dilshan/speaker-selector/ecad/speaker_selector.pdf

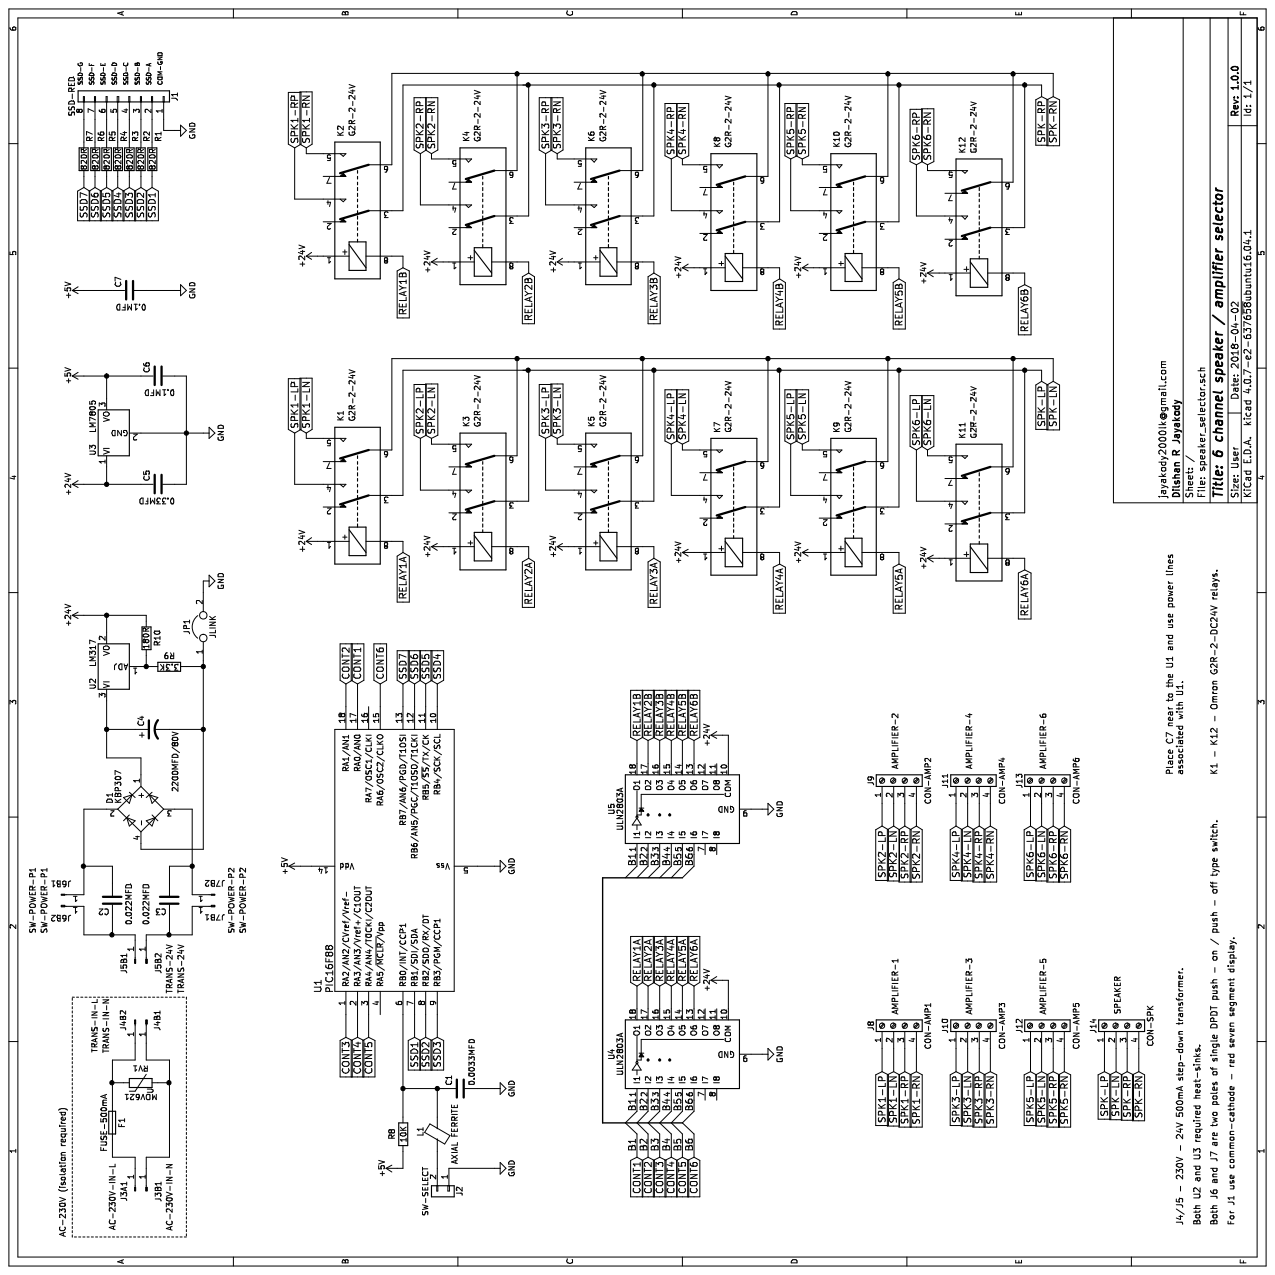
[picture p1: page 1]
