dilshan/speaker-selector/ecad/speaker_selector.sch

## KiCad design ecad/speaker_selector.sch (2018-04-17)

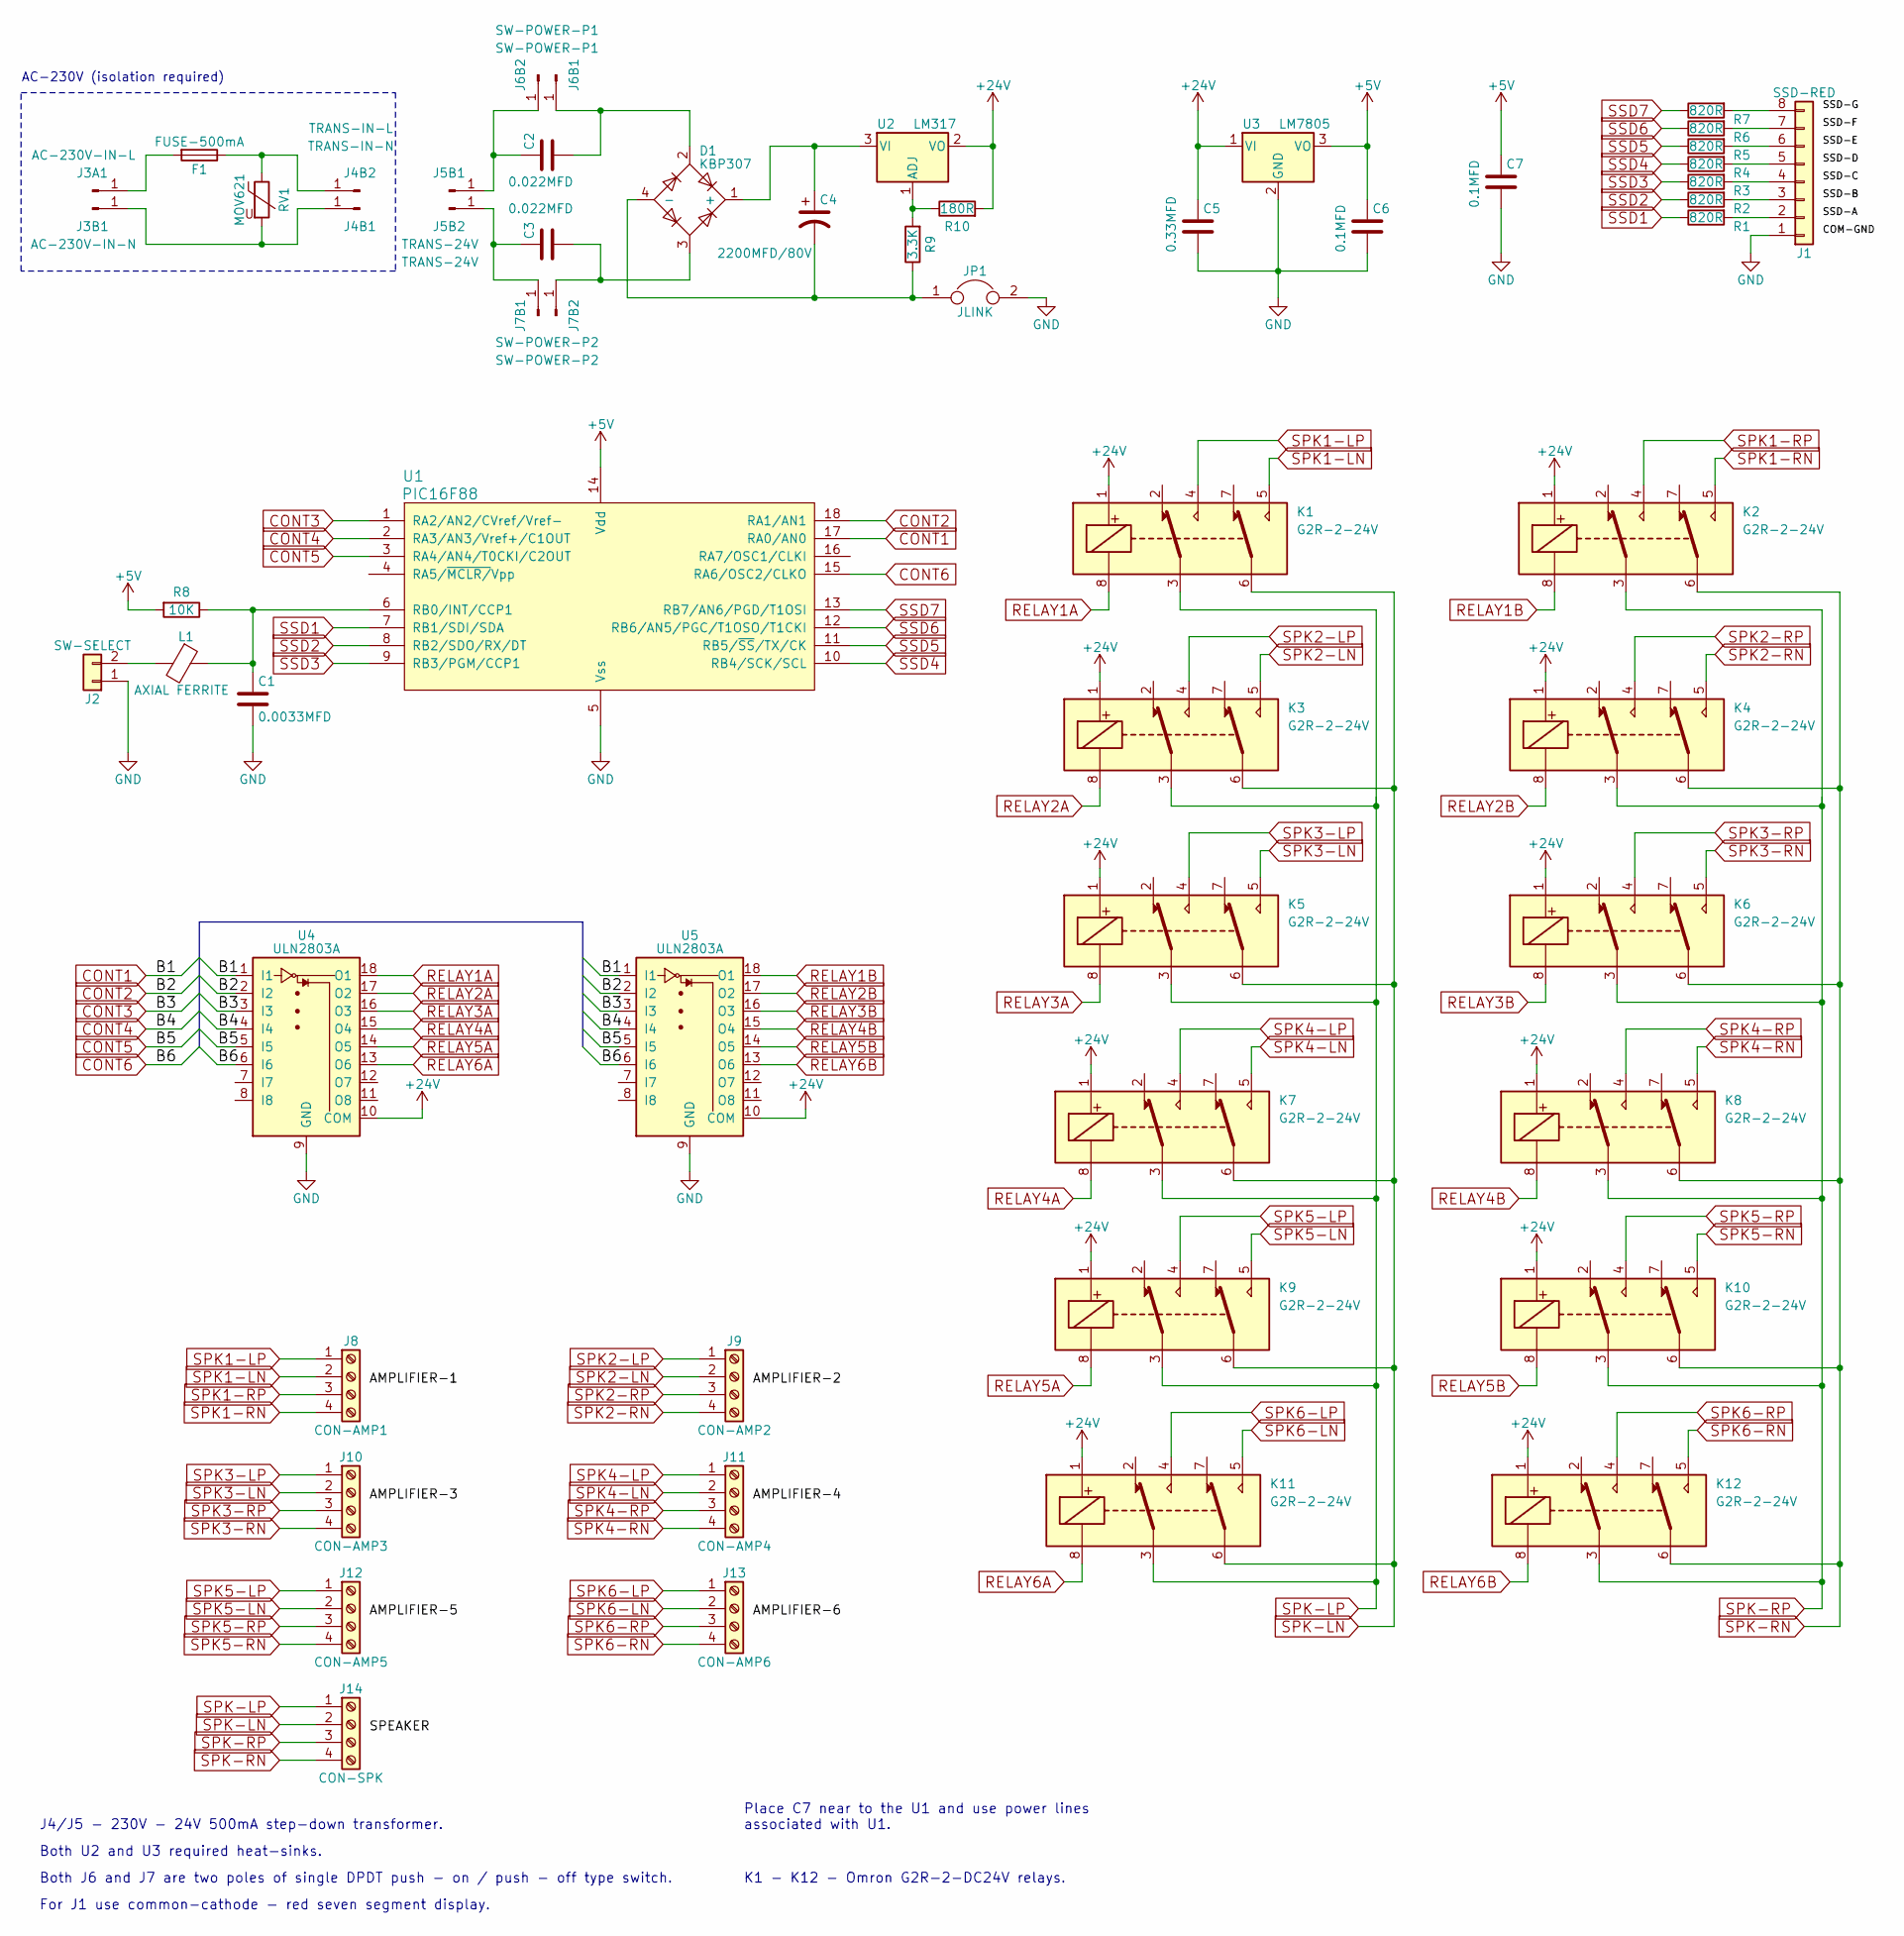
[picture p2: schematic speaker_selector.sch]

Parts:
C1: 0.0033MFD; C_Disc_D4.7mm_W2.5mm_P5.00mm
C2, C3: 0.022MFD; C_Rect_L19.0mm_W9.0mm_P15.00mm_MKS4
C4: 2200MFD/80V; CP_Radial_D16.0mm_P7.50mm
C5: 0.33MFD; C_Rect_L7.0mm_W6.0mm_P5.00mm
C6, C7: 0.1MFD; C_Rect_L7.0mm_W4.5mm_P5.00mm
D1: KBP307
F1: FUSE-500mA; Fuseholder5x20_horiz_open_inline_Type-I
J1: SSD-RED
J2: SW-SELECT
J3A1: AC-230V-IN-L
J3B1: AC-230V-IN-N
J4B1: TRANS-IN-L
J4B2: TRANS-IN-N
J5B1, J5B2: TRANS-24V
J6B1, J6B2: SW-POWER-P1
J7B1, J7B2: SW-POWER-P2
J8: CON-AMP1
J9: CON-AMP2
J10: CON-AMP3
J11: CON-AMP4
J12: CON-AMP5
J13: CON-AMP6
J14: CON-SPK
JP1: JLINK
K1, K2, K3, K4, K5, K6, K7, K8, K9, K10, K11, K12: G2R-2-24V
L1: AXIAL FERRITE; Choke_Horizontal_RM10mm
R1, R2, R3, R4, R5, R6, R7: 820R; R_Axial_DIN0204_L3.6mm_D1.6mm_P7.62mm_Horizontal
R8: 10K; R_Axial_DIN0204_L3.6mm_D1.6mm_P7.62mm_Horizontal
R9: 3.3K; R_Axial_DIN0204_L3.6mm_D1.6mm_P7.62mm_Horizontal
R10: 180R; R_Axial_DIN0204_L3.6mm_D1.6mm_P7.62mm_Horizontal
RV1: MOV621; RV_Disc_D15.5_W3.9_P7.5
U1: PIC16F88; DIP-18_W7.62mm_LongPads
U2: LM317; TO-220_Vertical
U3: LM7805; TO-220_Vertical
U4, U5: ULN2803A; DIP-18_W7.62mm_LongPads

Connections:
+5V: C6.1, C7.1, R8.2, U1.14 (Vdd), U3.3 (VO)
+24V: C5.1, K1.1, K2.1, K3.1, K4.1, K5.1, K6.1, K7.1, K8.1, K9.1, K10.1, K11.1, K12.1, R10.2, U2.2 (VO), U3.1 (VI), U4.10 (COM), U5.10 (COM)
CONT1: U1.17 (RA0/AN0), U4.1 (I1), U5.1 (I1)
CONT2: U1.18 (RA1/AN1), U4.2 (I2), U5.2 (I2)
CONT3: U1.1 (RA2/AN2/CVref/Vref-), U4.3 (I3), U5.3 (I3)
CONT4: U1.2 (RA3/AN3/Vref+/C1OUT), U4.4 (I4), U5.4 (I4)
CONT5: U1.3 (RA4/AN4/T0CKI/C2OUT), U4.5 (I5), U5.5 (I5)
CONT6: U1.15 (RA6/OSC2/CLKO), U4.6 (I6), U5.6 (I6)
GND: C1.2, C5.2, C6.2, C7.2, J1.1, J2.1, JP1.2, U1.5 (Vss), U3.2 (GND), U4.9 (GND), U5.9 (GND)
unnamed: C1.1, L1.1, R8.1, U1.6 (RB0/INT/CCP1)
unnamed: C2.1, J5B1.1, J6B1.1
unnamed: C2.2, D1.2, J6B2.1
unnamed: C3.1, J5B2.1, J7B1.1
unnamed: C3.2, D1.3, J7B2.1
unnamed: C4.1, D1.1 (+), U2.3 (VI)
unnamed: C4.2, D1.4 (-), JP1.1, R9.1
unnamed: F1.1, J4B1.1, RV1.1
unnamed: F1.2, J3A1.1
unnamed: J1.2, R1.2
unnamed: J1.3, R2.2
unnamed: J1.4, R3.2
unnamed: J1.5, R4.2
unnamed: J1.6, R5.2
unnamed: J1.7, R6.2
unnamed: J1.8, R7.2
unnamed: J2.2, L1.2
unnamed: J3B1.1, J4B2.1, RV1.2
unnamed: R9.2, R10.1, U2.1 (ADJ)
RELAY1A: K1.8, U4.18 (O1)
RELAY1B: K2.8, U5.18 (O1)
RELAY2A: K3.8, U4.17 (O2)
RELAY2B: K4.8, U5.17 (O2)
RELAY3A: K5.8, U4.16 (O3)
RELAY3B: K6.8, U5.16 (O3)
RELAY4A: K7.8, U4.15 (O4)
RELAY4B: K8.8, U5.15 (O4)
RELAY5A: K9.8, U4.14 (O5)
RELAY5B: K10.8, U5.14 (O5)
RELAY6A: K11.8, U4.13 (O6)
RELAY6B: K12.8, U5.13 (O6)
SPK1-LN: J8.2, K1.5
SPK1-LP: J8.1, K1.4
SPK1-RN: J8.4, K2.5
SPK1-RP: J8.3, K2.4
SPK2-LN: J9.2, K3.5
SPK2-LP: J9.1, K3.4
SPK2-RN: J9.4, K4.5
SPK2-RP: J9.3, K4.4
SPK3-LN: J10.2, K5.5
SPK3-LP: J10.1, K5.4
SPK3-RN: J10.4, K6.5
SPK3-RP: J10.3, K6.4
SPK4-LN: J11.2, K7.5
SPK4-LP: J11.1, K7.4
SPK4-RN: J11.4, K8.5
SPK4-RP: J11.3, K8.4
SPK5-LN: J12.2, K9.5
SPK5-LP: J12.1, K9.4
SPK5-RN: J12.4, K10.5
SPK5-RP: J12.3, K10.4
SPK6-LN: J13.2, K11.5
SPK6-LP: J13.1, K11.4
SPK6-RN: J13.4, K12.5
SPK6-RP: J13.3, K12.4
SPK-LN: J14.2, K1.6, K3.6, K5.6, K7.6, K9.6, K11.6
SPK-LP: J14.1, K1.3, K3.3, K5.3, K7.3, K9.3, K11.3
SPK-RN: J14.4, K2.6, K4.6, K6.6, K8.6, K10.6, K12.6
SPK-RP: J14.3, K2.3, K4.3, K6.3, K8.3, K10.3, K12.3
SSD1: R1.1, U1.7 (RB1/SDI/SDA)
SSD2: R2.1, U1.8 (RB2/SDO/RX/DT)
SSD3: R3.1, U1.9 (RB3/PGM/CCP1)
SSD4: R4.1, U1.10 (RB4/SCK/SCL)
SSD5: R5.1, U1.11 (RB5/~SS~/TX/CK)
SSD6: R6.1, U1.12 (RB6/AN5/PGC/T1OSO/T1CKI)
SSD7: R7.1, U1.13 (RB7/AN6/PGD/T1OSI)

Notes on the sheet:
Both U2 and U3 required heat-sinks.
Both J6 and J7 are two poles of single DPDT push - on / push - off type switch.
For J1 use common-cathode - red seven segment display.
J4/J5 - 230V - 24V 500mA step-down transformer.
Place C7 near to the U1 and use power lines associated with U1.
K1 - K12 - Omron G2R-2-DC24V relays.
AC-230V (isolation required)
